flaviusone/BlackBox-Minisumo/Blackbox v1.0/mini-sumo 1/Scheme PCB/main_board.pdf

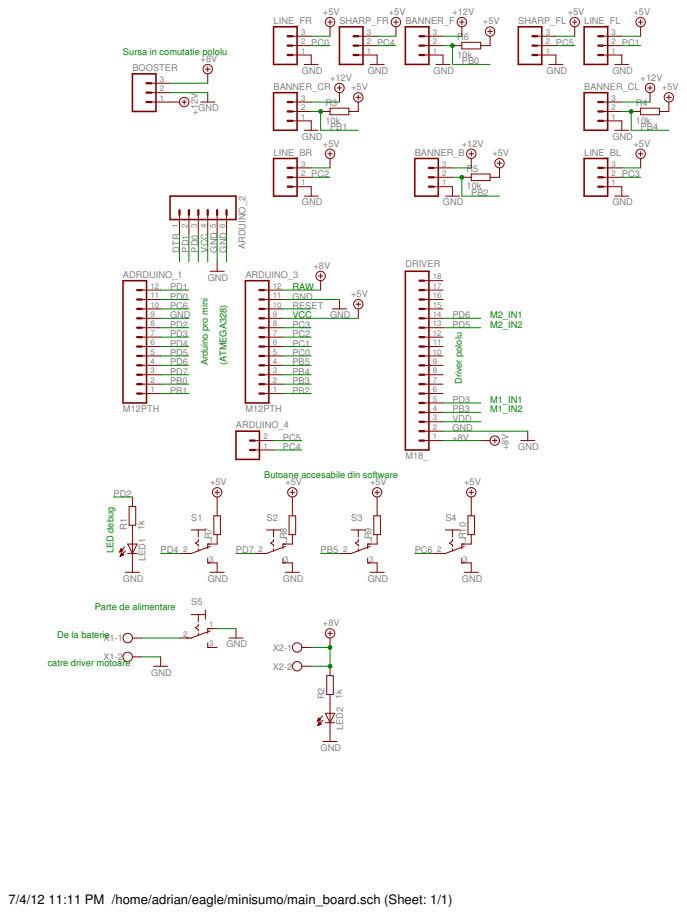
[picture p1: page 1]

2 PC0 | 2 PC4

LED debug Sursa in comutatie pololu
3 BOOSTER

Butoane accesabile din software

7/4/12 11:11 PM /home/adrian/eagle/minisumo/main_board.sch (Sheet: 1/1)
