flaviusone/BlackBox-Minisumo/Blackbox Pro/Hardware/Mini Sumo/baza.brd

## EAGLE design Blackbox Pro/Hardware/Mini Sumo/baza.brd (2014-05-03)

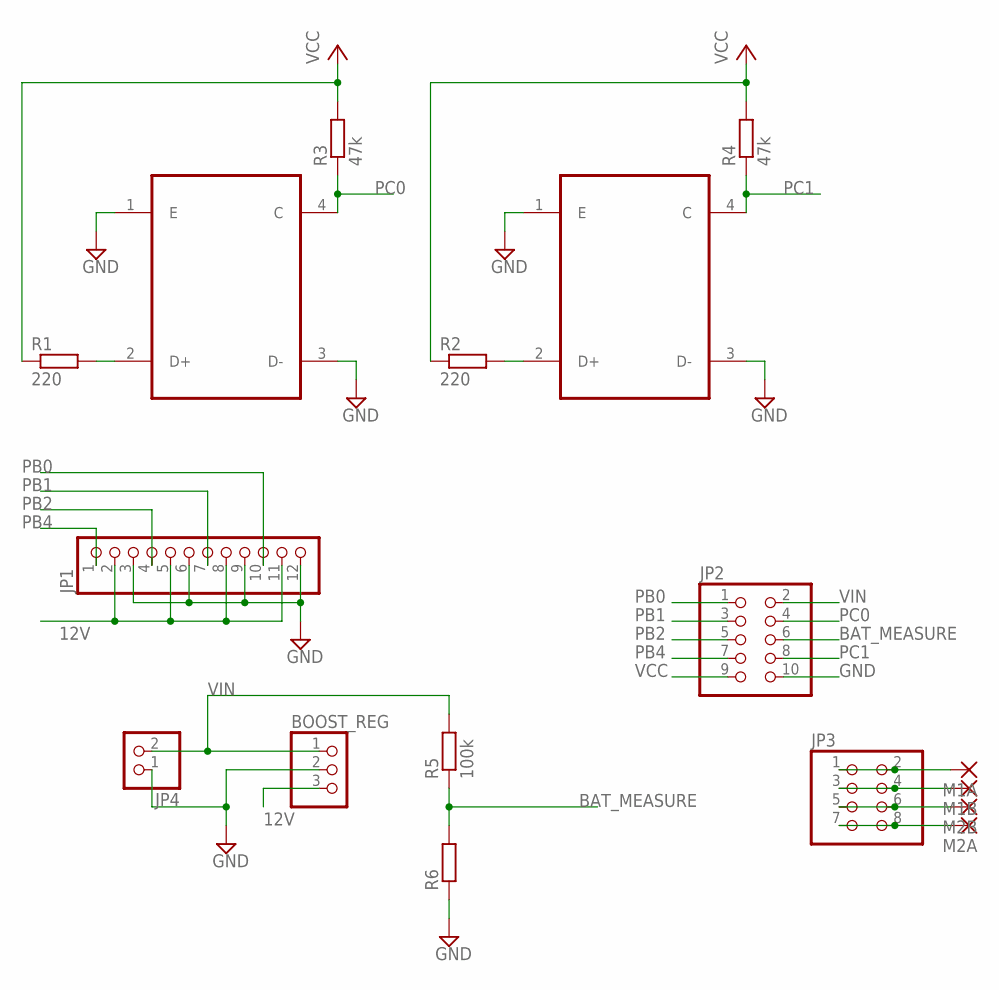
[picture p2: schematic baza.sch]

Parts:
BOOST_REG: PINHD-1X3; 1X03
IR1, IR2: TCNT2000
JP1: PINHD-1X12-CB; 1X12-CB
JP2: PINHD-2X5; 2X05
JP3: PINHD-2X4; 2X04
JP4: PINHD-1X2; 1X02
M1A, M1B, M2A, M2B: 2,15/1,0
R1, R2: 220; M1206
R3, R4: 47k; M1206
R5: 100k; R1206
R6: R-EU_R1206; R1206

Connections:
12V: BOOST_REG.3, JP1.2, JP1.5, JP1.8, JP1.11
BAT_MEASURE: JP2.6, R5.1, R6.2
GND: BOOST_REG.2, IR1.1 (E), IR1.3 (D-), IR2.1 (E), IR2.3 (D-), JP1.3, JP1.6, JP1.9, JP1.12, JP2.10, JP4.1, R6.1
unnamed: IR1.2 (D+), R1.2
unnamed: JP3.1, JP3.2, M1A.1
unnamed: IR2.2 (D+), R2.2
unnamed: JP3.3, JP3.4, M1B.1
unnamed: JP3.5, JP3.6, M2B.1
unnamed: JP3.7, JP3.8, M2A.1
PB0: JP1.10, JP2.1
PB1: JP1.7, JP2.3
PB2: JP1.4, JP2.5
PB4: JP1.1, JP2.7
PC0: IR1.4 (C), JP2.4, R3.1
PC1: IR2.4 (C), JP2.8, R4.1
VCC: JP2.9, R1.1, R2.1, R3.2, R4.2
VIN: BOOST_REG.1, JP2.2, JP4.2, R5.2

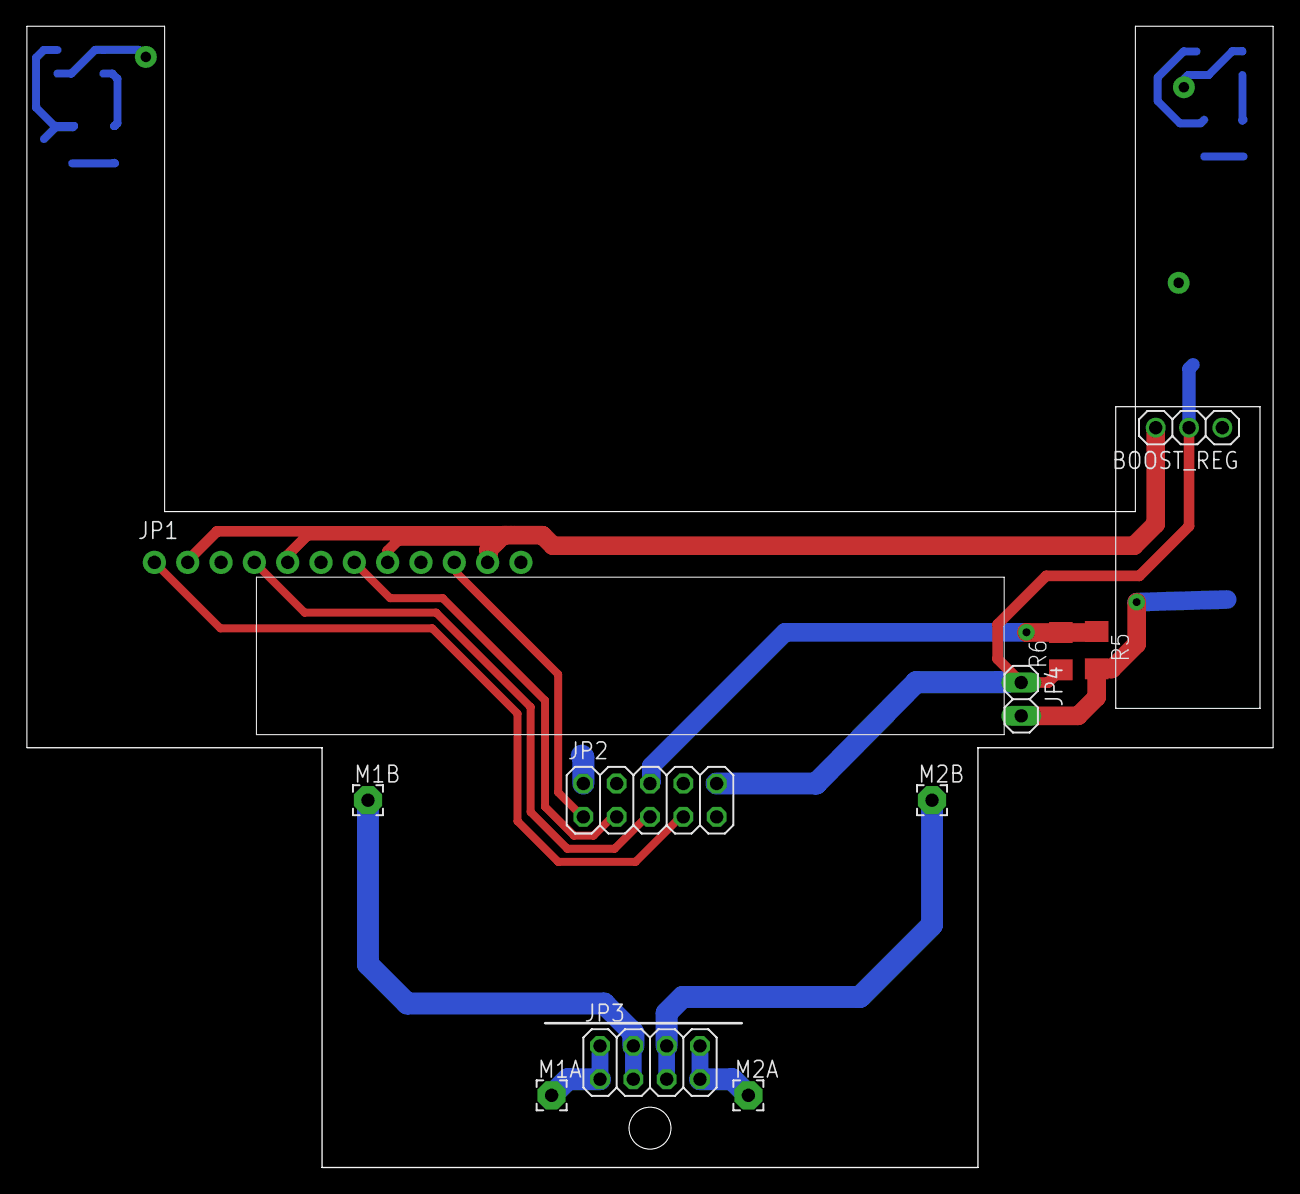
[picture p3: board baza.brd from above]

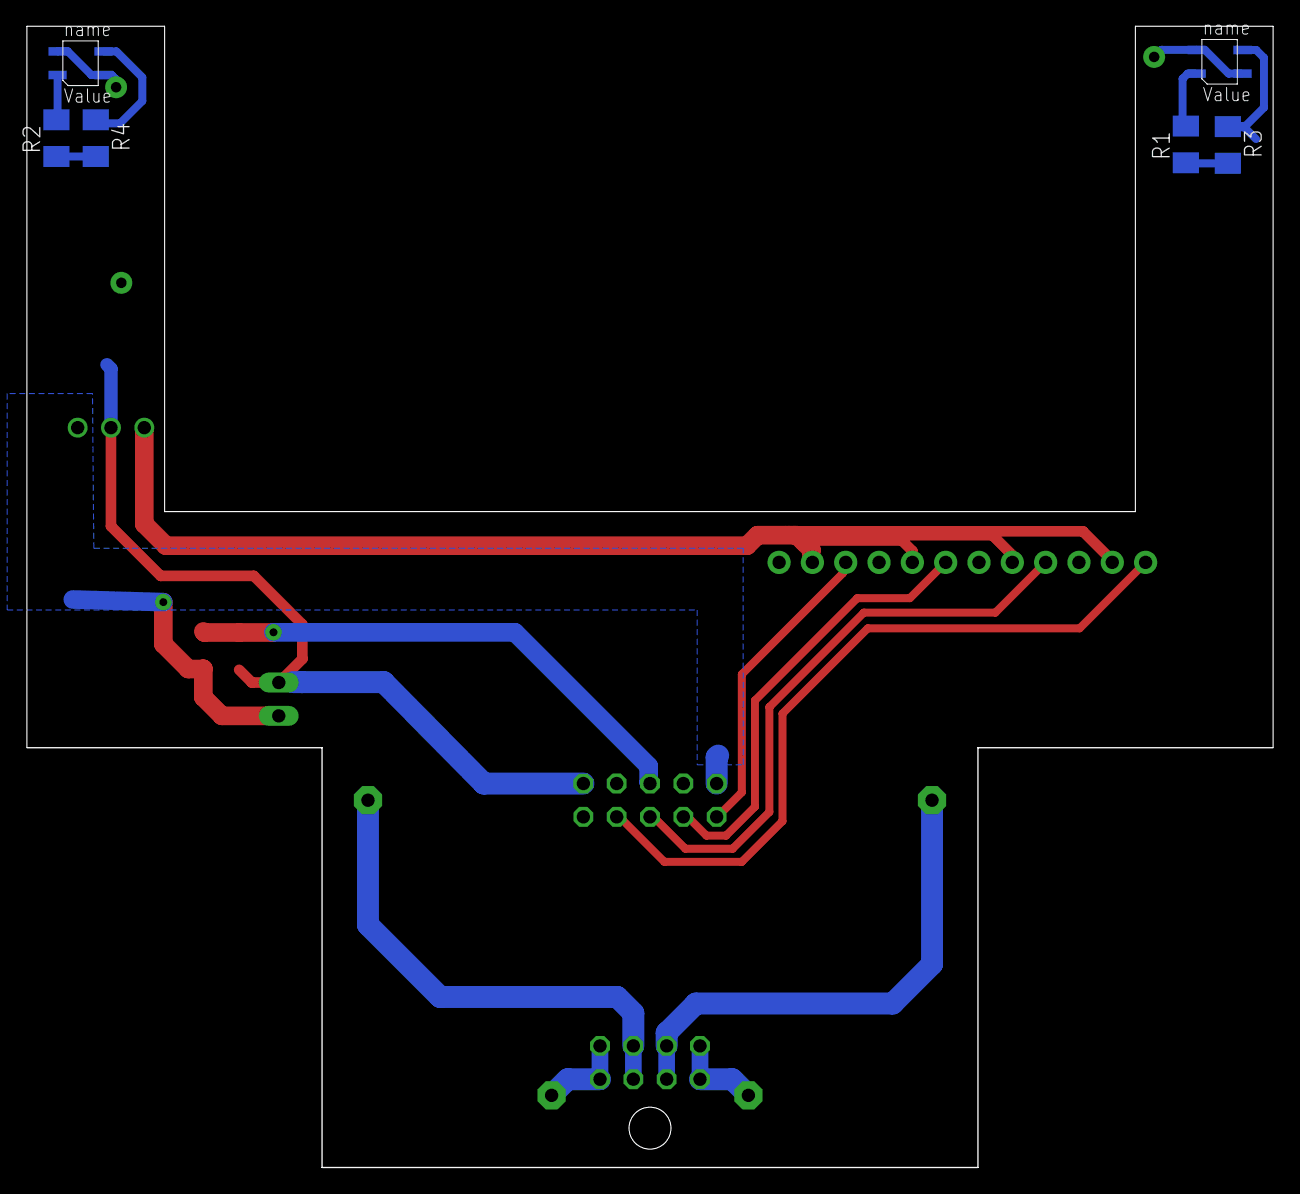
[picture p4: board baza.brd from below]

Board: 2 copper layers, 95.0 x 87.0 mm, 17 parts (6 on the bottom side), 17 nets.
