flaviusone/BlackBox-Minisumo/Blackbox Pro/Hardware/Mini Sumo/control.brd

## EAGLE design Blackbox Pro/Hardware/Mini Sumo/control.brd (2014-05-03)

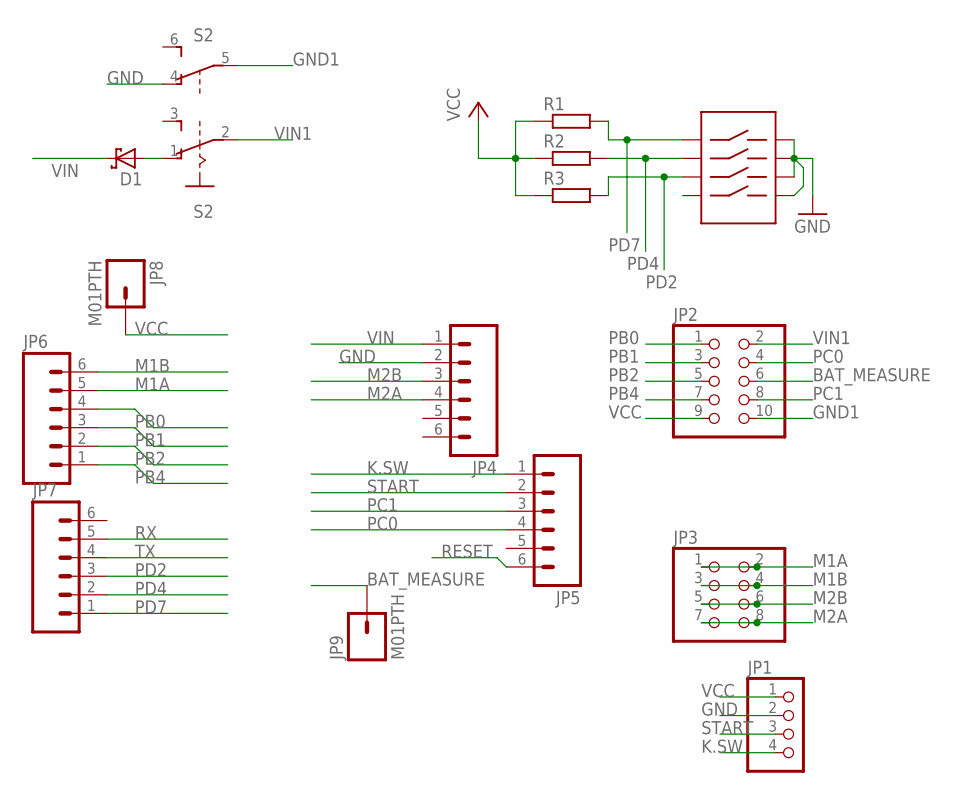
[picture p5: schematic control.sch]

Parts:
D1: SCHOTTKY-DIODESMC; SMC
JP1: PINHD-1X4; 1X04
JP2: PINHD-2X5; 2X05
JP3: PINHD-2X4; 2X04
JP4, JP5, JP6, JP7: M06SMD-STRAIGHT; 1X06_SMD_STRAIGHT
JP8, JP9: M01PTH; 1X01
R1, R2, R3: R-EU_R0805; R0805
S2: A68-A31
U$2: DGH04; GDH04

Connections:
BAT_MEASURE: JP2.6, JP9.1
GND: JP1.2, JP4.2, S2.4 (O), U$2.P$1, U$2.P$6, U$2.P$7, U$2.P$8
GND1: JP2.10, S2.5
K.SW: JP1.4, JP5.1
M1A: JP3.1, JP3.2, JP6.5
M1B: JP3.3, JP3.4, JP6.6
M2A: JP3.7, JP3.8, JP4.4
M2B: JP3.5, JP3.6, JP4.3
unnamed: D1.A, S2.1 (O)
PB0: JP2.1, JP6.4
PB1: JP2.3, JP6.3
PB2: JP2.5, JP6.2
PB4: JP2.7, JP6.1
PC0: JP2.4, JP5.4
PC1: JP2.8, JP5.3
PD2: JP7.3, R3.2, U$2.P$4
PD4: JP7.2, R2.2, U$2.P$3
PD7: JP7.1, R1.2, U$2.P$2
RESET: JP5.6
RX: JP7.5
START: JP1.3, JP5.2
TX: JP7.4
VCC: JP1.1, JP2.9, JP8.1, R1.1, R2.1, R3.1
VIN: D1.C, JP4.1
VIN1: JP2.2, S2.2

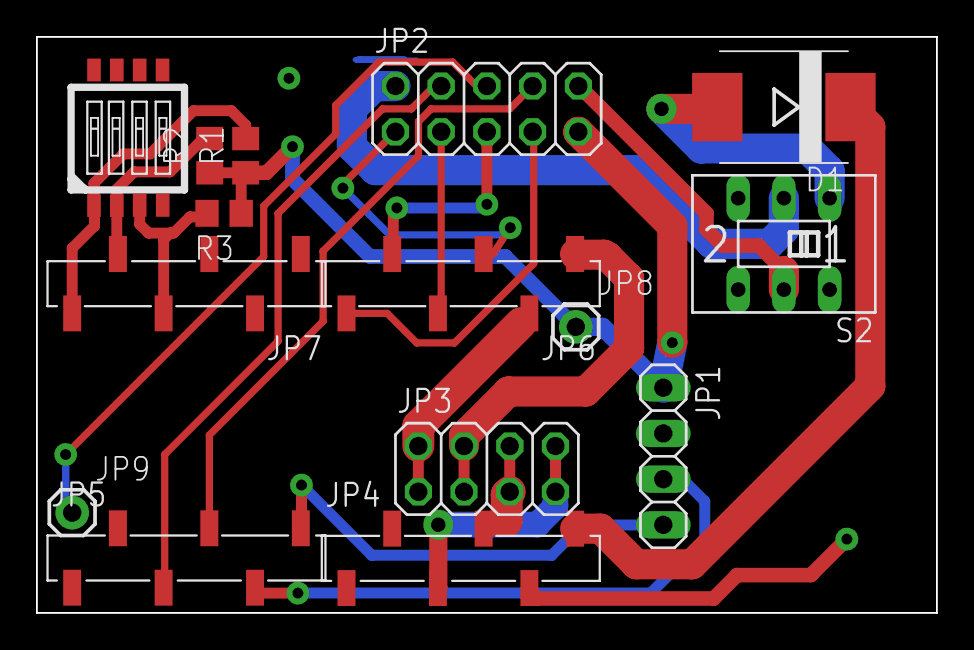
[picture p6: board control.brd from above]

Board: 2 copper layers, 50.0 x 32.0 mm, 15 parts (0 on the bottom side), 22 nets.
