flaviusone/BlackBox-Minisumo/Blackbox Pro/Hardware/sharp/s340k.brd

## EAGLE design Blackbox Pro/Hardware/sharp/s340k.brd (2014-05-03)

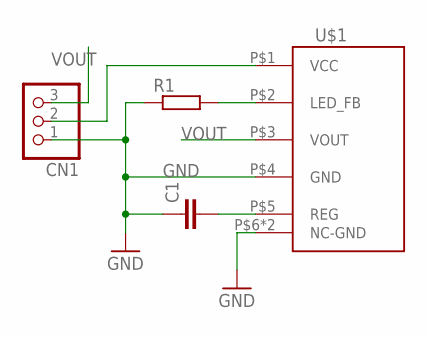
[picture p7: schematic s340k.sch]

Parts:
C1: C-EUC0805; C0805
CN1: JST_3PIN; JSTPH3
R1: R-EU_R1206; R1206
U$1: 340K; SHARP_340K

Connections:
GND: C1.1, CN1.1, R1.1, U$1.P$4 (GND), U$1.P$6 (NC-GND), U$1.P$7 (NC-GND)
unnamed: R1.2, U$1.P$2 (LED_FB)
unnamed: C1.2, U$1.P$5 (REG)
VCC: CN1.2, U$1.P$1 (VCC)
VOUT: CN1.3, U$1.P$3 (VOUT)

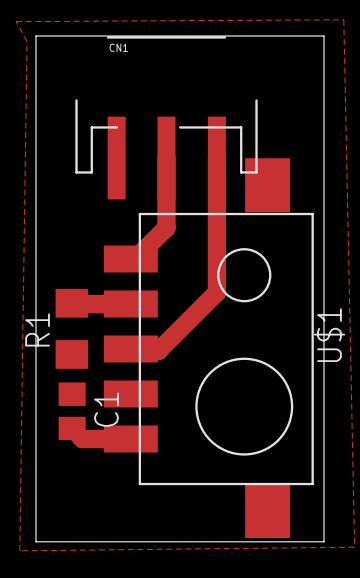
[picture p8: board s340k.brd from above]

Board: 2 copper layers, 16.0 x 28.1 mm, 4 parts (0 on the bottom side), 5 nets.
