flaviusone/BlackBox-Minisumo/Blackbox v2.0/hardware/untitled.brd

## EAGLE design Blackbox v2.0/hardware/untitled.brd (2013-11-02, an earlier design)

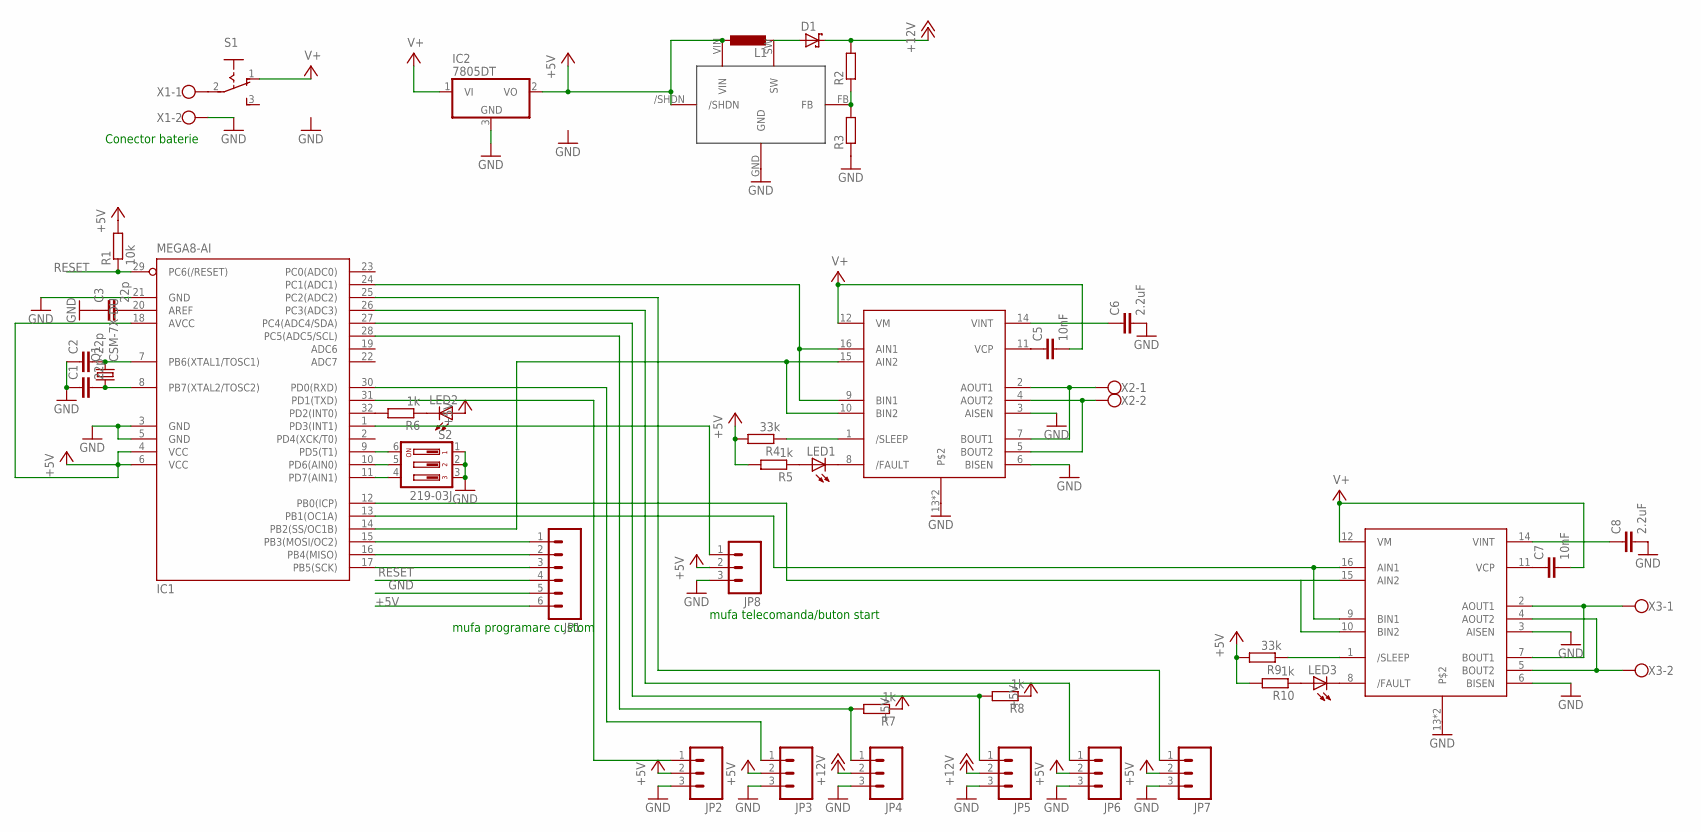
[picture p9: schematic untitled.sch]

Parts:
C1, C2, C3: 22p; C0805
C5, C7: 10nF; C0805
C6, C8: 2.2uF; C0805
D1: SCHOTTKY-DIODESMD; SMB
IC1: MEGA8-AI; TQFP32-08
IC2: 7805DT; TO252
JP1: M06SIP; 1X06
JP2, JP3, JP4, JP5, JP6, JP7, JP8: M03PTH; 1X03
L1: L-EUL4532C; L4532M
LED1, LED2, LED3: LEDSML0805; SML0805
Q1: CSM-7X-DU
R1: 10k; R0805
R2, R3: R-EU_R0805; R0805
R4, R9: 33k; R0805
R5, R6, R7, R8, R10: 1k; R0805
S1: 255SB
S2: 219-03J; CTS-219-03J
U$1: LM2703; SOT23
U$2, U$3: DRV8833-PWP; PW
X1, X2, X3: W237-102

Connections:
+5V: IC1.4 (VCC), IC1.6 (VCC), IC1.18 (AVCC), IC2.2 (VO), JP1.6, JP2.2, JP3.2, JP6.2, JP7.2, JP8.2, L1.1, LED2.A, R1.2, R4.2, R5.2, R7.1, R8.1, R9.2, R10.2, U$1./SHDN, U$1.VIN
+12V: D1.C, JP4.2, JP5.2, R2.2
GND: C1.1, C2.1, C3.1, C6.2, C8.2, IC1.3 (GND), IC1.5 (GND), IC1.21 (GND), IC2.3 (GND), JP1.5, JP2.3, JP3.3, JP4.3, JP5.3, JP6.3, JP7.3, JP8.3, R3.1, S2.1, S2.2, S2.3, U$1.GND, U$2.3 (AISEN), U$2.6 (BISEN), U$2.13, U$2.PAD, U$3.3 (AISEN), U$3.6 (BISEN), U$3.13, U$3.PAD, X1.2
unnamed: C2.2, IC1.7 (PB6(XTAL1/TOSC1)), Q1.2
unnamed: C1.2, IC1.8 (PB7(XTAL2/TOSC2)), Q1.1
unnamed: S1.2, X1.1
unnamed: IC1.17 (PB5(SCK)), JP1.3
unnamed: IC1.16 (PB4(MISO)), JP1.2
unnamed: IC1.15 (PB3(MOSI/OC2)), JP1.1
unnamed: D1.A, L1.2, U$1.SW
unnamed: R4.1, U$2.1 (/SLEEP)
unnamed: R2.1, R3.2, U$1.FB
unnamed: LED1.C, U$2.8 (/FAULT)
unnamed: LED1.A, R5.1
unnamed: U$2.2 (AOUT1), U$2.7 (BOUT1), X2.1
unnamed: U$2.4 (AOUT2), U$2.5 (BOUT2), X2.2
unnamed: R9.1, U$3.1 (/SLEEP)
unnamed: LED3.C, U$3.8 (/FAULT)
unnamed: C5.1, U$2.11 (VCP)
unnamed: C6.1, U$2.14 (VINT)
unnamed: IC1.12 (PB0(ICP)), U$3.10 (BIN2), U$3.15 (AIN2)
unnamed: IC1.24 (PC1(ADC1)), U$2.9 (BIN1), U$2.16 (AIN1)
unnamed: IC1.13 (PB1(OC1A)), U$3.9 (BIN1), U$3.16 (AIN1)
unnamed: IC1.14 (PB2(SS/OC1B)), U$2.10 (BIN2), U$2.15 (AIN2)
unnamed: IC1.9 (PD5(T1)), S2.6
unnamed: IC1.10 (PD6(AIN0)), S2.5
unnamed: IC1.11 (PD7(AIN1)), S2.4
unnamed: IC1.1 (PD3(INT1)), JP8.1
unnamed: IC1.31 (PD1(TXD)), JP2.1
unnamed: IC1.30 (PD0(RXD)), JP3.1
unnamed: IC1.28 (PC5(ADC5/SCL)), JP4.1, R7.2
unnamed: IC1.27 (PC4(ADC4/SDA)), JP5.1, R8.2
unnamed: IC1.26 (PC3(ADC3)), JP6.1
unnamed: IC1.25 (PC2(ADC2)), JP7.1
unnamed: IC1.32 (PD2(INT0)), R6.2
unnamed: LED2.C, R6.1
unnamed: LED3.A, R10.1
unnamed: C7.1, U$3.11 (VCP)
unnamed: C8.1, U$3.14 (VINT)
unnamed: C3.2, IC1.20 (AREF)
unnamed: U$3.4 (AOUT2), U$3.5 (BOUT2), X3.2
unnamed: U$3.2 (AOUT1), U$3.7 (BOUT1), X3.1
RESET: IC1.29 (PC6(/RESET)), JP1.4, R1.1
V+: C5.2, C7.2, IC2.1 (VI), S1.1 (O), U$2.12 (VM), U$3.12 (VM)

Notes on the sheet:
Conector baterie
mufa telecomanda/buton start
mufa programare custom

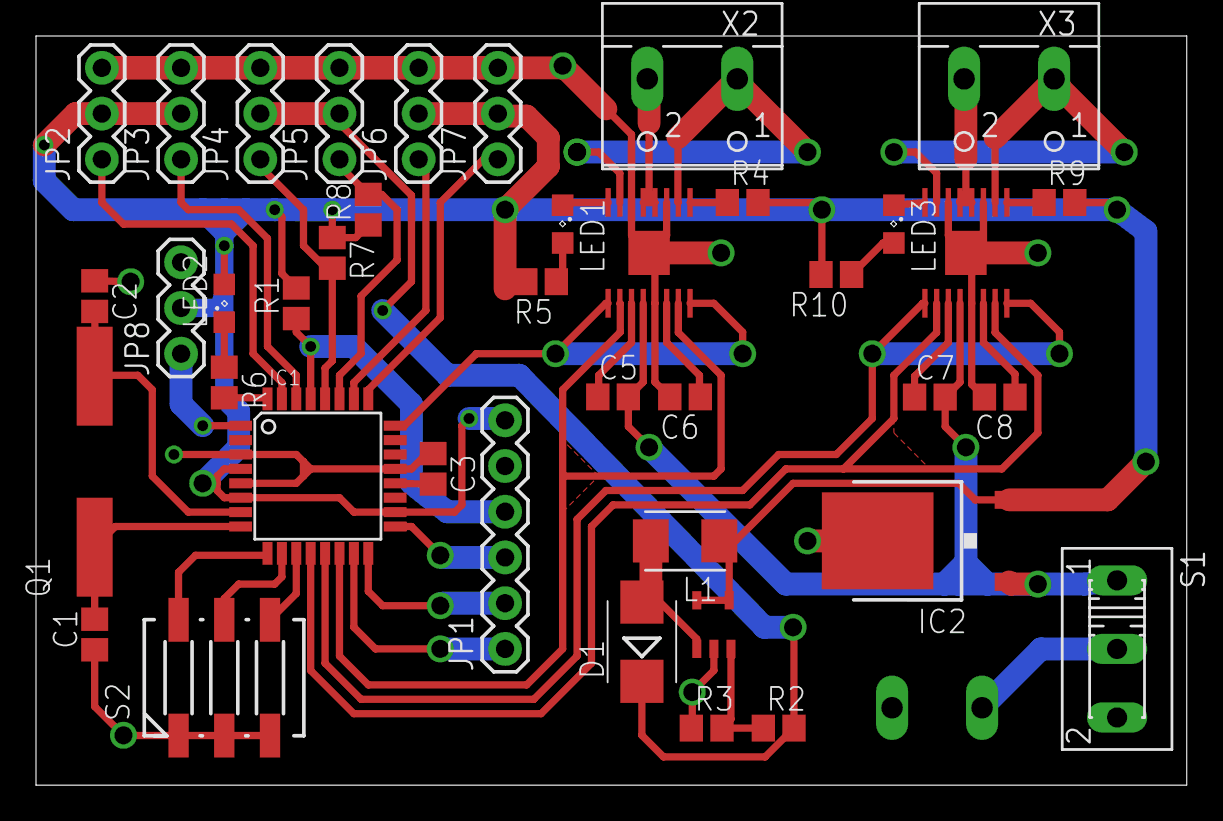
[picture p10: board untitled.brd from above]

Board: 2 copper layers, 63.9 x 41.6 mm, 41 parts (1 on the bottom side), 44 nets.
