flaviusone/BlackBox-Minisumo/(commit log)

2013-04-10 Mass Add
    [Senzori.xlsx, main_board.brd, main_board.sch]
2013-04-23 Added millis to avid line
2013-04-23 Removed millis from line avoid
    [functii_miscare.ino]
2013-04-23 Adaugat viteze rapide la evitari
2013-04-23 Incearcare fara delay cu millis
2013-04-23 Varianta cu rotire doar cu o roata la iesirea din teren
2013-10-20 Mutat fisiere in Blackbox v1.0
    [Senzori.xlsx, main_board.brd, main_board.sch]
2013-10-20 Adaugat fisiere HW si SW pt ver noua
    [untitled.brd, untitled.sch]
2013-11-02 Adaug placa in versiunea noua
    (mufa de programare cu 6 pini si condensator pt ADC)
    [untitled.brd, untitled.sch]
2013-11-21 Blackbox v2.1 is alive !
    [untitled.brd, untitled.sch]
2013-11-22 Adaugat strategie de test
2014-05-01 Blackbox Pro
    [untitled.brd, untitled.sch]
2014-05-03 Added schematics + code changes
    [baza.brd, baza.sch, control.brd, control.sch, s340k.brd, s340k.sch, untitled.brd, untitled.sch]
2014-05-09 Locul 3 la locala
2014-11-06 Bug fixes
    Disablat senzorii laterali pe Pro. Reparat bug directie default.
    [atac_0.ino, atac_1.ino, atac_2.ino, atac_3.ino, atac_4.ino, atac_5.ino, atac_6.ino, atac_7.ino]
